asu-rdl/Primecam-Bias/README.md

# Primecam-Bias

See [https://asu-rdl.github.io/Primecam-Bias/](https://asu-rdl.github.io/Primecam-Bias/)
