asu-rdl/Primecam-Bias/docs/index.md

---
layout: default
---

# Intro
The CCAT observatory's instrument "Prime-Cam" requires a power supply for a large array of low-noise amplifiers. 
They want to have easy to use, programmable control over the power supply (also referred to as 'bias supply').
We (ASU) aim to deliver on that need. Within these docs, you can find 

# Table Of Contents

1. [Raspberry Pi Bringup](raspberrypi.html)
1. [Getting Started](gettingstarted.html)
1. [Software](software.html)
1. [Hardware](hardware.html)
