asu-rdl/Primecam-Bias/board/primecamLNABiasPotVreg-CostComp.ods

Option # | Description | Board Fab | Assemble | Parts Cost | ETA | Total
1 | JLC Fab + Assemble | 244.3 | 6939.98 | 0 | 2 weeks | 7184.28
2 | JLC Fab + ASU Assemble | 244.3 | 0 | 3114.22 | Much longer | 3358.52
 |  |  |  |  | Difference | 3825.76
