asu-rdl/Primecam-Bias/board/551XX09F.stp

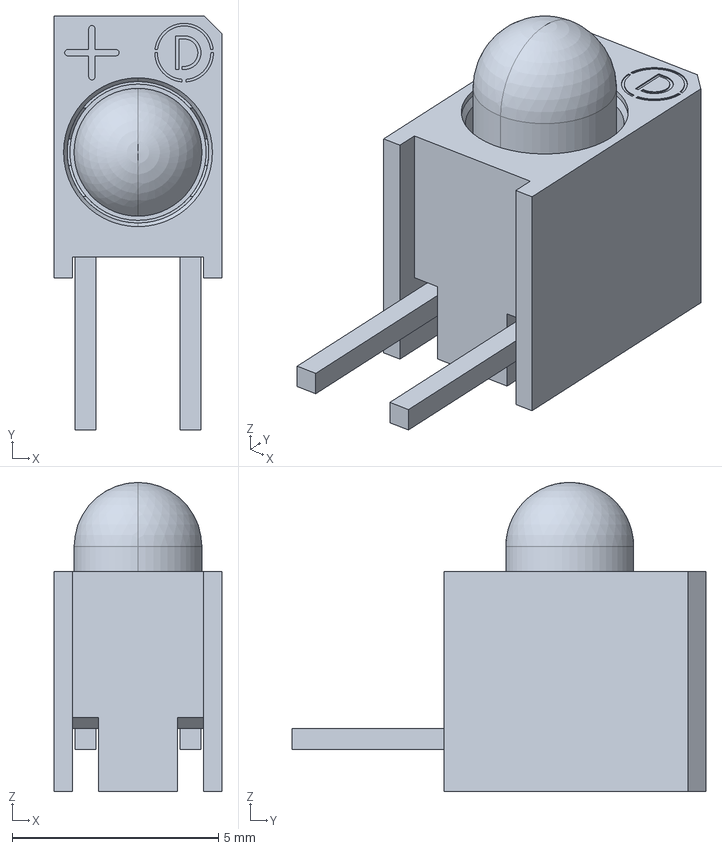
[picture p3: CAD file, 2025-06-06]
board/551XX09F.stp
4.06 x 10.0 x 7.49 mm
