asu-rdl/Primecam-Bias/buggyTodo.md

- [ ] Missing commands to enable a testload
- [ ] Wiper is not being correctly set during seek_voltage command.
- [ ] Implement seek_current
