asu-rdl/Primecam-Bias/docs/todo.md

---
layout: default
---

# Todo
---
- [ ]  How do we make sure poetry sets up the CLI as an executable.

# Notes
---
