asu-rdl/Primecam-Bias/docs/primecamLNABiasPotVreg.pdf

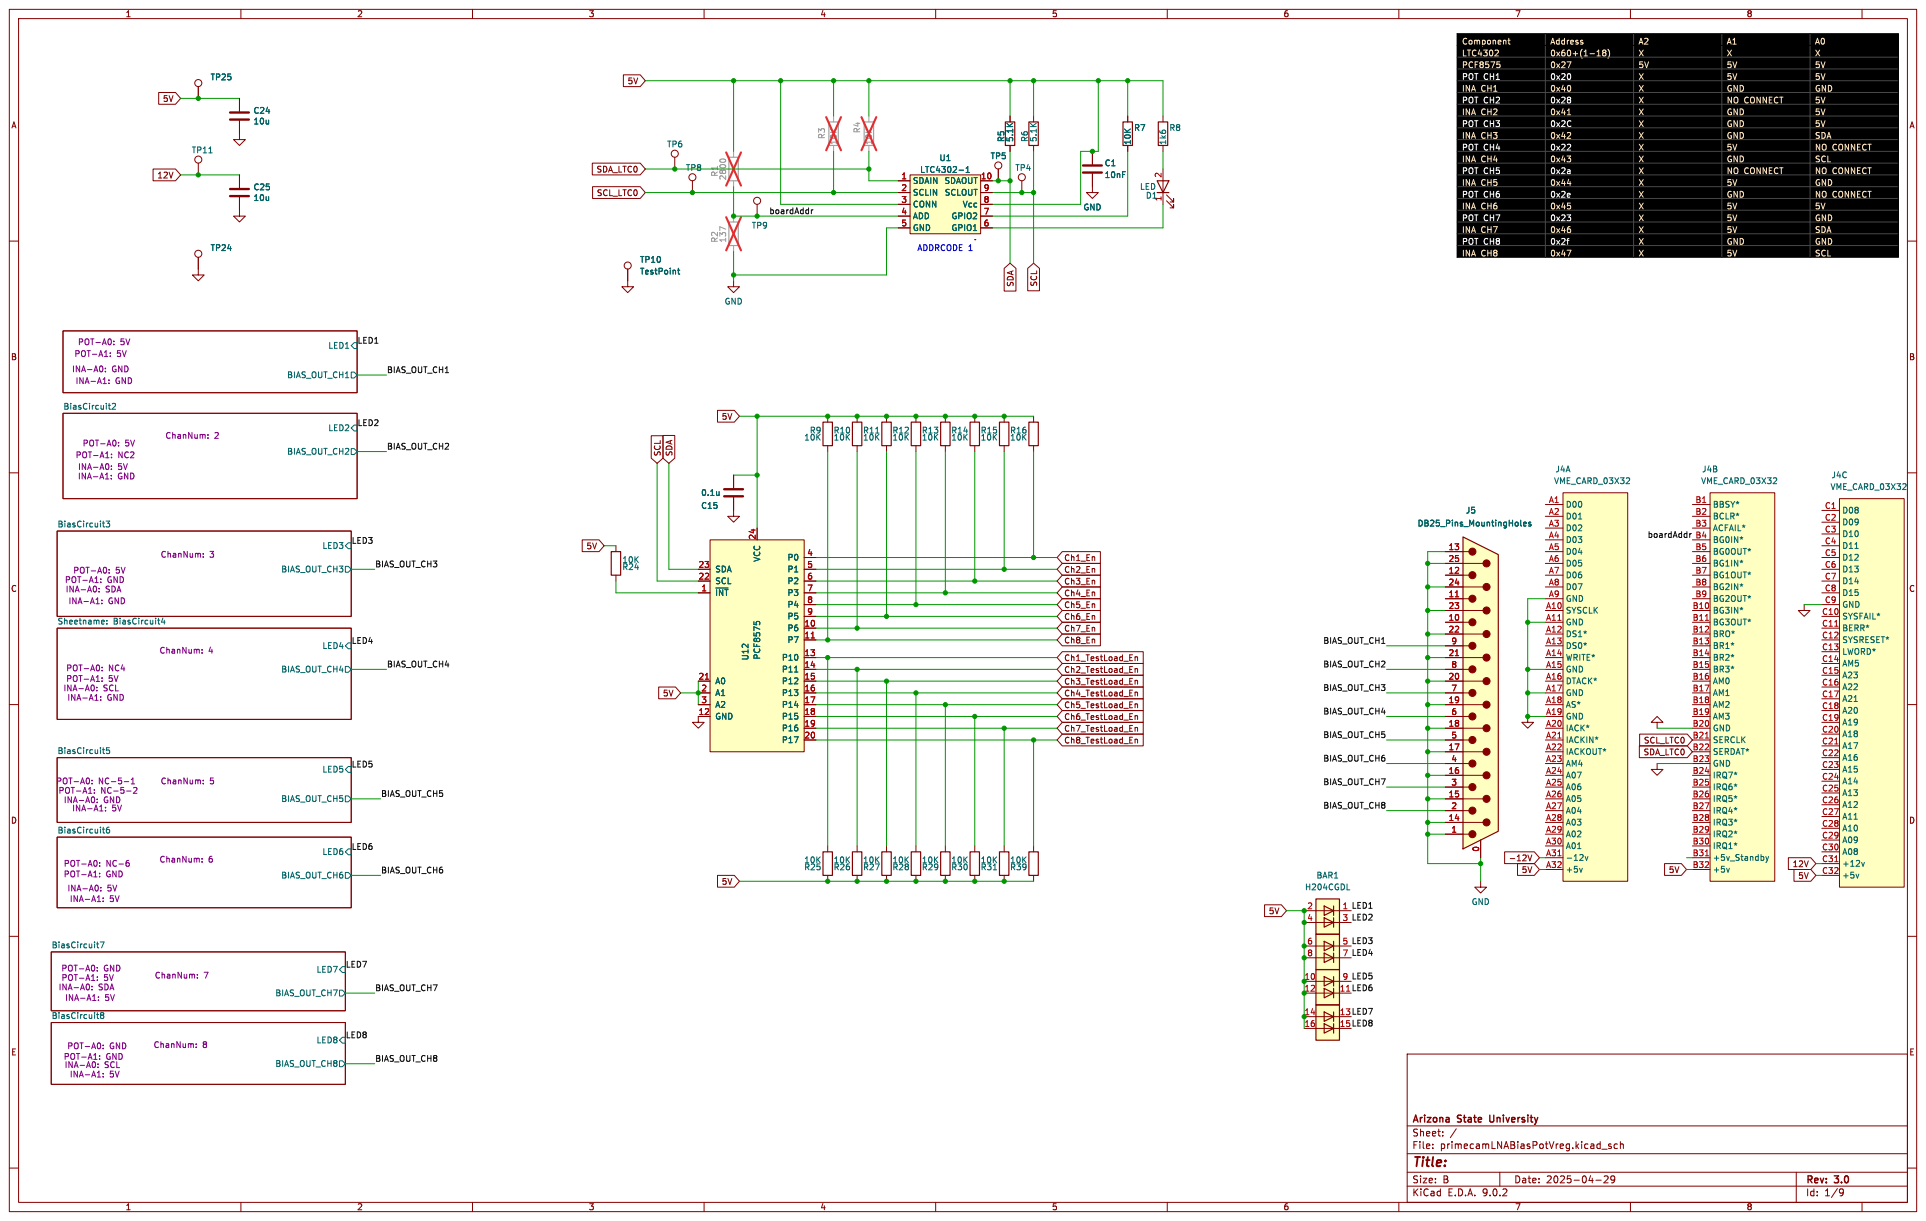
[picture p4: page 1]

Component | Address | A2 | A1 | A0
LTC4302 | 0x60+(1-18) | X | X | X
PCF8575 | 0x27 | 5V | 5V | 5V
POT CH1 | 0x20 | X | 5V | 5V
INA CH1 | 0x40 | X | GND | GND
POT CH2 | 0x28 | X | NO CONNECT | 5V
INA CH2 | 0x41 | X | GND | 5V
POT CH3 | 0x2C | X | GND | 5V
INA CH3 | 0x42 | X | GND | SDA
POT CH4 | 0x22 | X | 5V | NO CONNECT
INA CH4 | 0x43 0x2a | X X | GND NO CONNECT | SCL POT CH5 NO CONNECT

INA CH5 | 0x44 | X | 5V | GND
POT CH6 | 0x2e | X | GND | NO CONNECT
INA CH6 | 0x45 | X | 5V | 5V
POT CH7 | 0x23 | X | 5V | GND
INA CH7 | 0x46 | X | 5V | SDA
POT CH8 | 0x2f | X | GND | GND

VME_CARD_03X32 D00 A1 D01 A2 D02 A3 D03 A4 D04 A5 D05 A6 D06 A7 D07 A8 GND A9 SYSCLK A10 GND A11 DS1* A12 DS0* A13 WRITE* A14 GND A15 DTACK* A16 GND A17 AS* A18 GND A19
BBSY* B1 BCLR* B2 ACFAIL* B3 BG0IN* B4 BG0OUT* B5 BG1IN* B6 BG1OUT* B7 BG2IN* B8 BG2OUT* B9 BG3IN* B10 BG3OUT* B11 BRO* B12 BR1* B13 BR2* B14 BR3* B15 AM0 B16 AM1 B17 AM2 B18 AM3 B19 GND

POT-A0: NC-6 POT-A1: GND

Id: 1/9 Title: File: primecamLNABiasPotVreg.kicad_sch Sheet: / Arizona State University

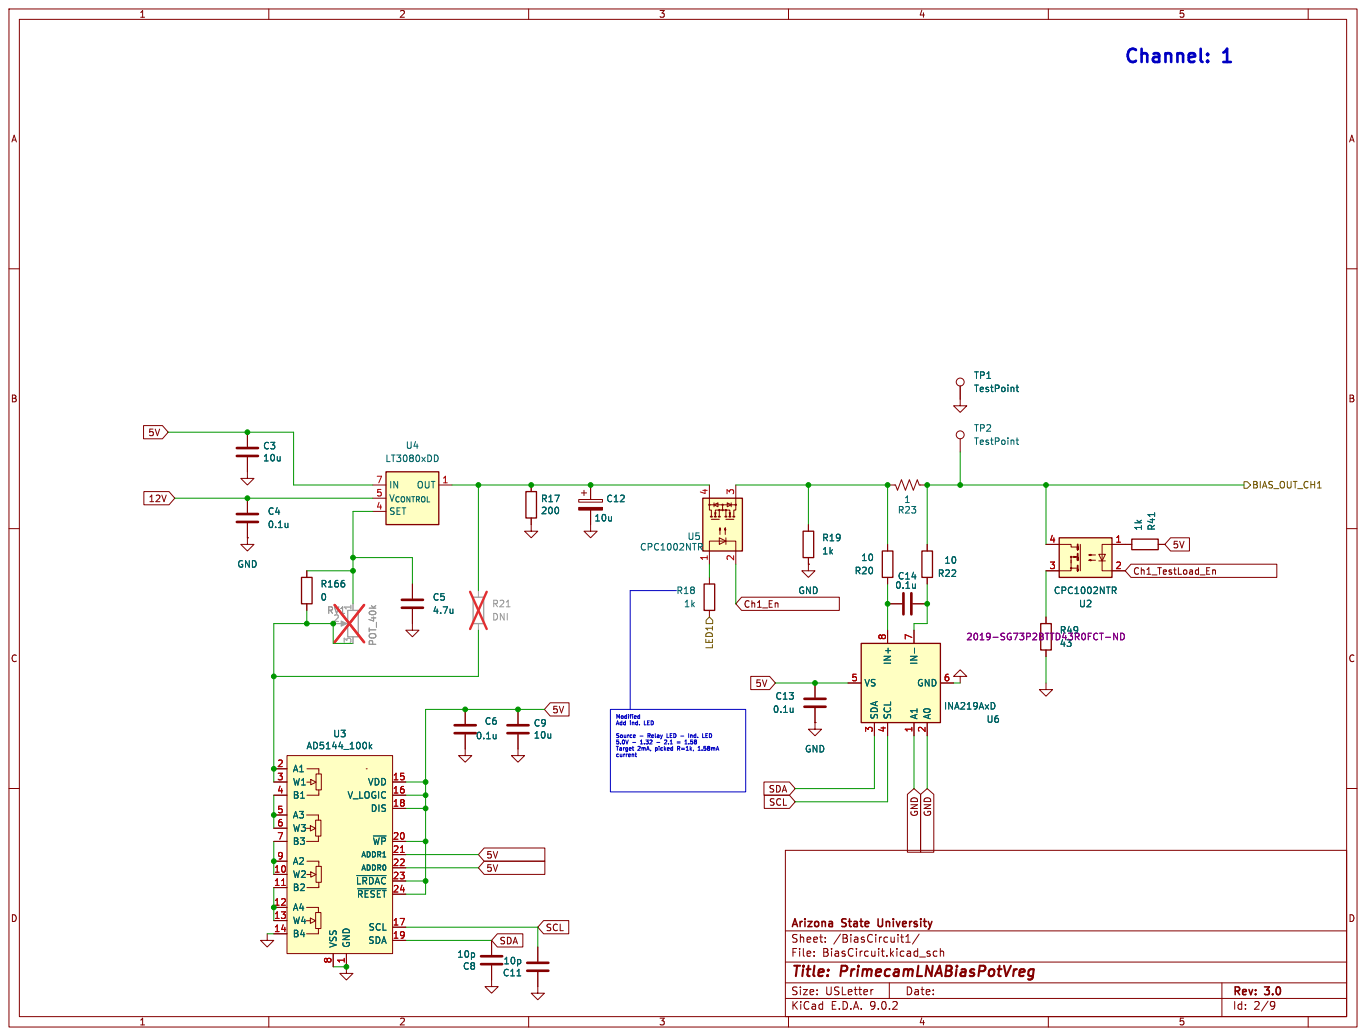
[picture p5: page 2]

File: BiasCircuit.kicad_sch Sheet: /BiasCircuit1/ Arizona State University C12

8 IN- 7 VS 5 GND 6 SDA
INA219AxD IN+

Modified Add ind. LED

Source - Relay LED - Ind. LED

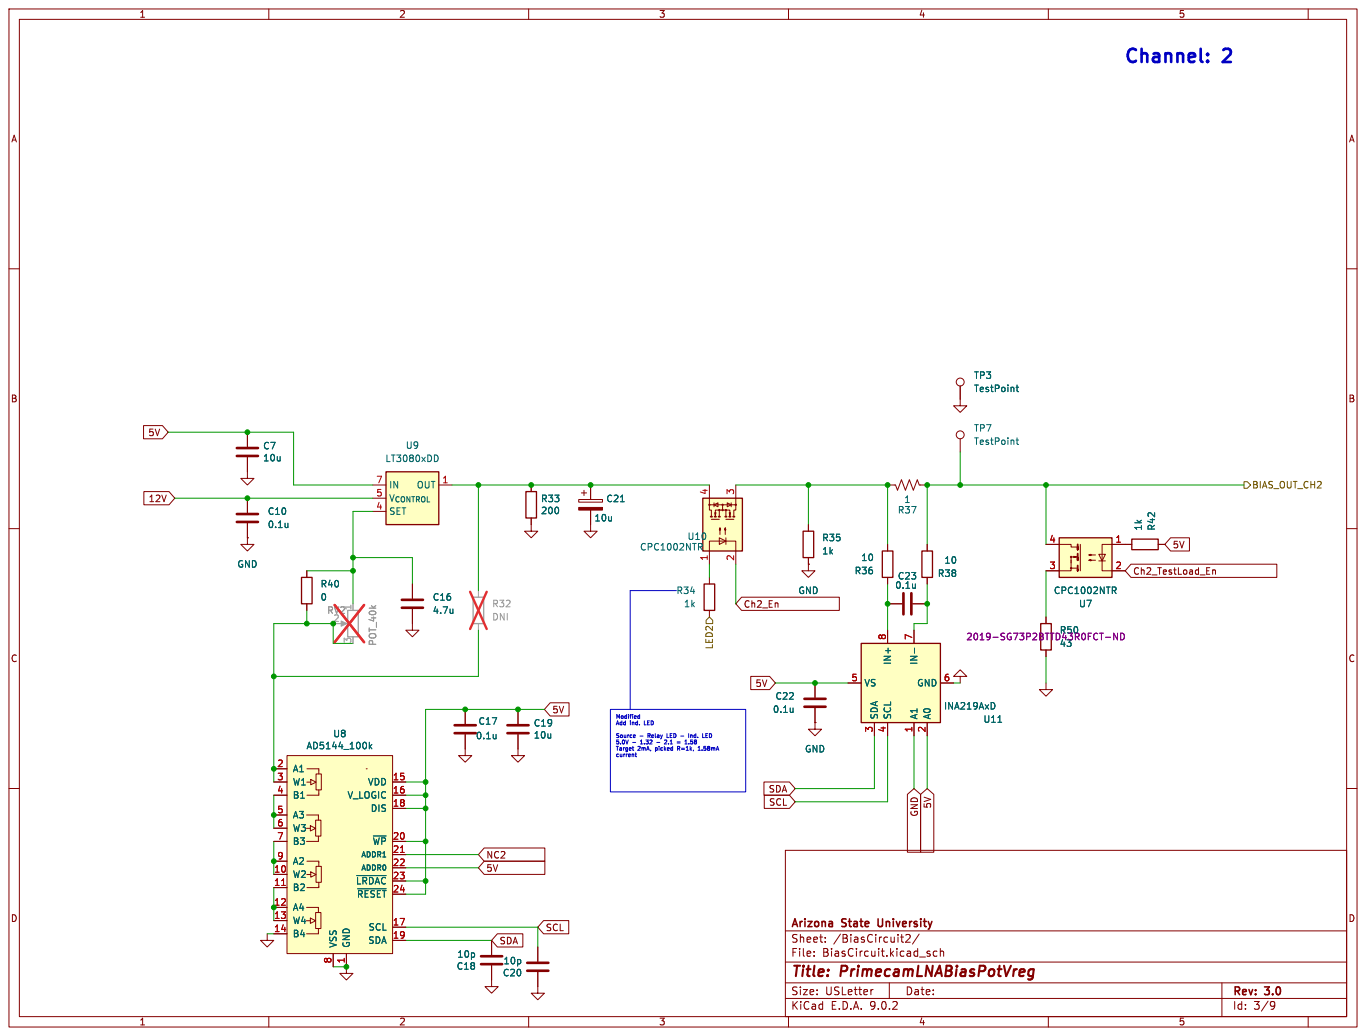
[picture p6: page 3]

File: BiasCircuit.kicad_sch Sheet: /BiasCircuit2/ Arizona State University R34

8 IN- 7 VS 5 GND 6 SDA
INA219AxD IN+

Modified Add ind. LED

Source - Relay LED - Ind. LED

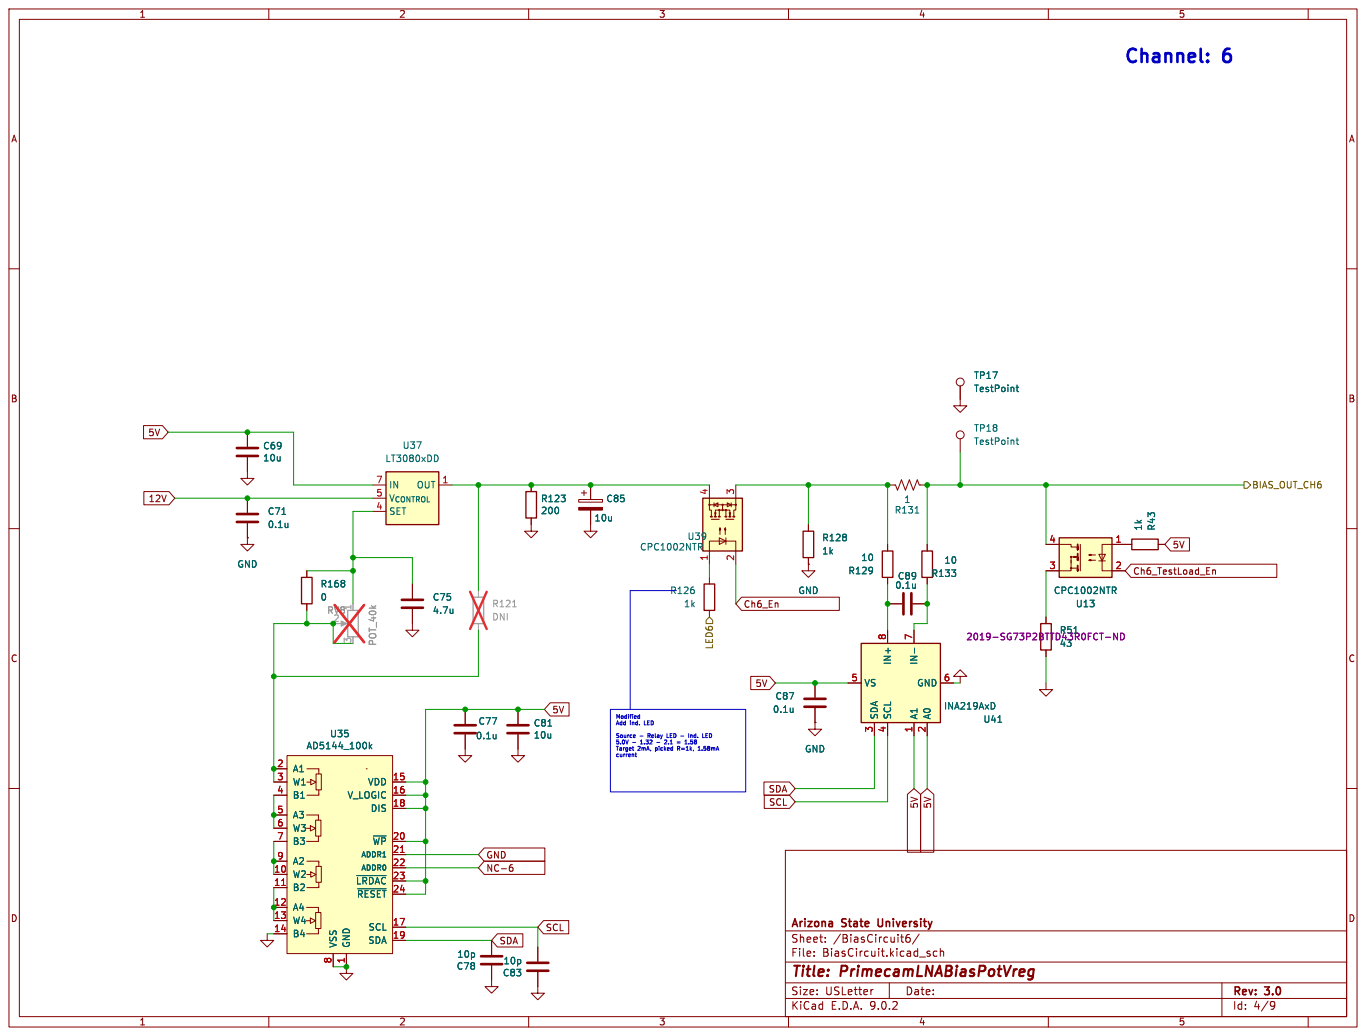
[picture p7: page 4]

8 IN- 7 VS 5 GND 6 SDA
INA219AxD IN+

Modified Add ind. LED

Source - Relay LED - Ind. LED

File: BiasCircuit.kicad_sch Sheet: /BiasCircuit6/ Arizona State University

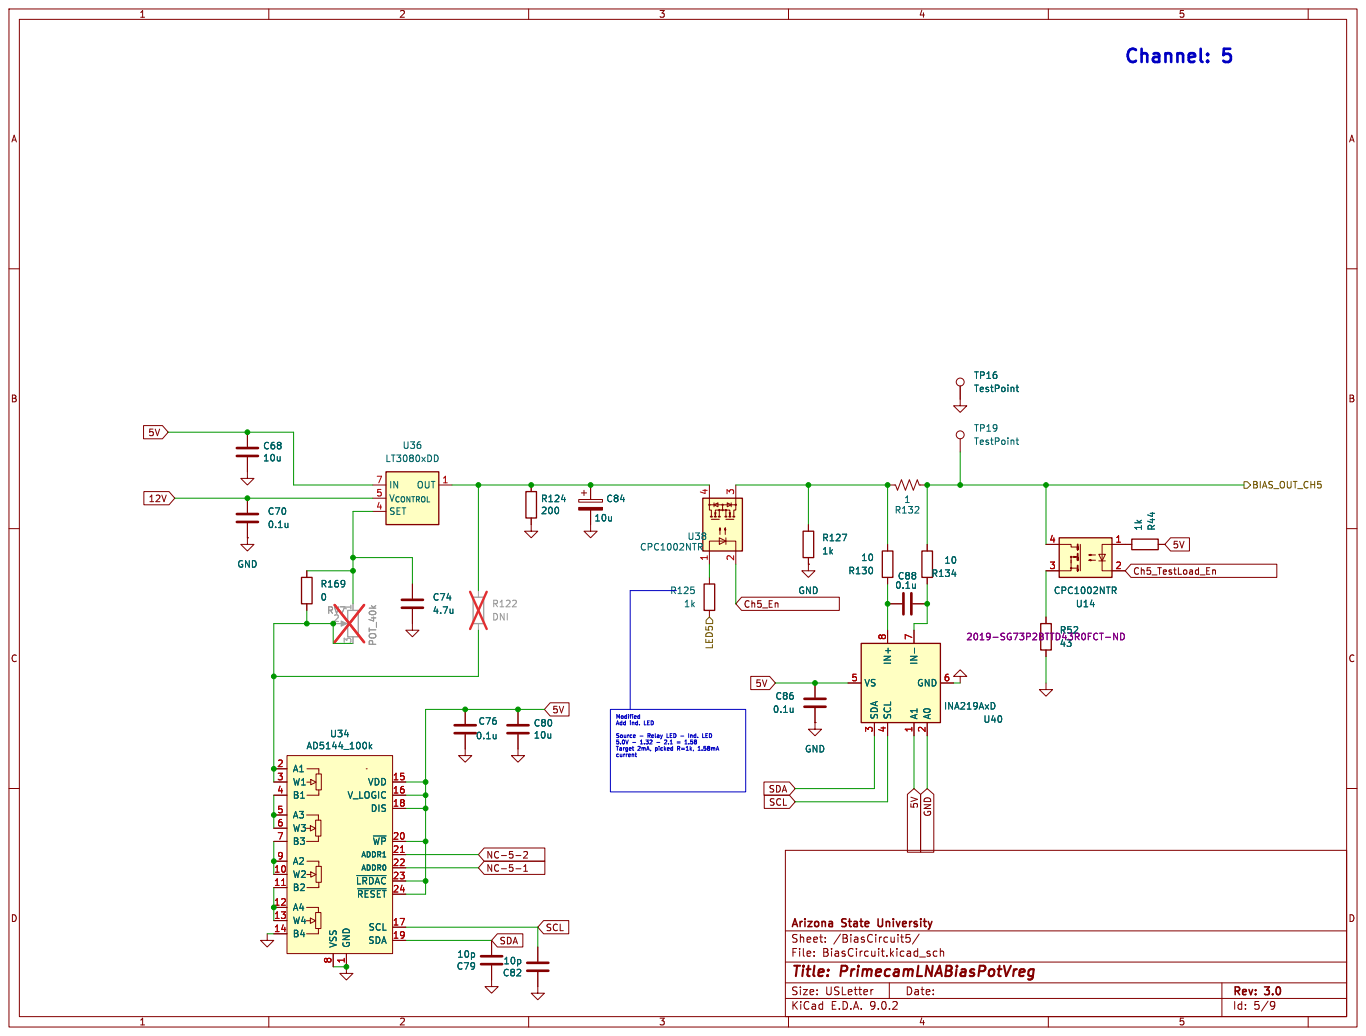
[picture p8: page 5]

File: BiasCircuit.kicad_sch Sheet: /BiasCircuit5/ Arizona State University C84

8 IN- 7 VS 5 GND 6 SDA
INA219AxD IN+

Modified Add ind. LED

Source - Relay LED - Ind. LED

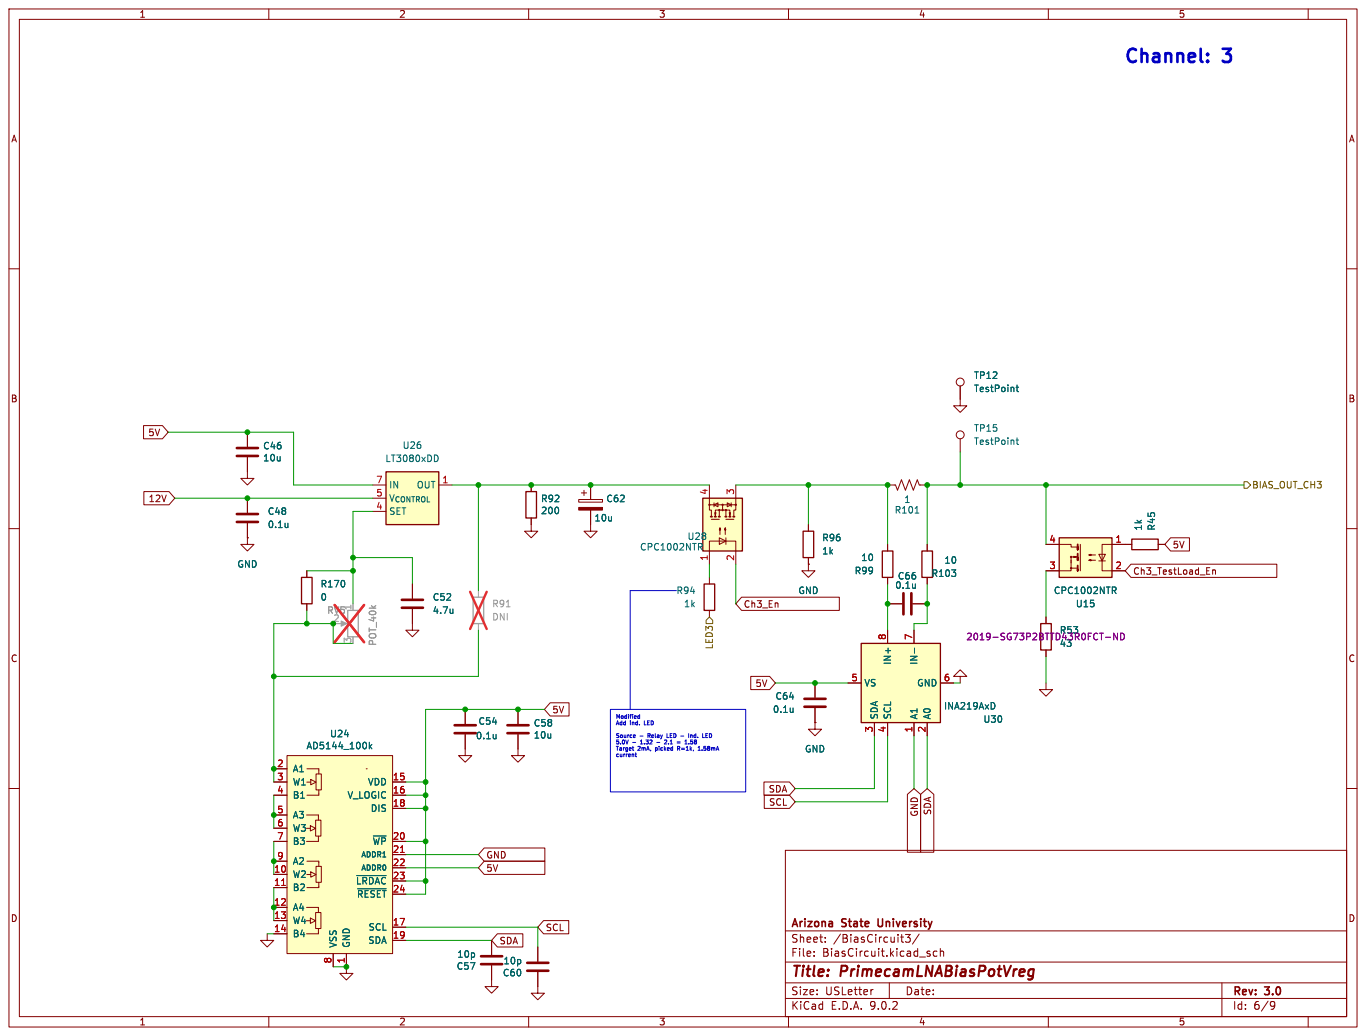
[picture p9: page 6]

File: BiasCircuit.kicad_sch Sheet: /BiasCircuit3/ Arizona State University R94

8 IN- 7 VS 5 GND 6 SDA
INA219AxD IN+

Modified Add ind. LED

Source - Relay LED - Ind. LED

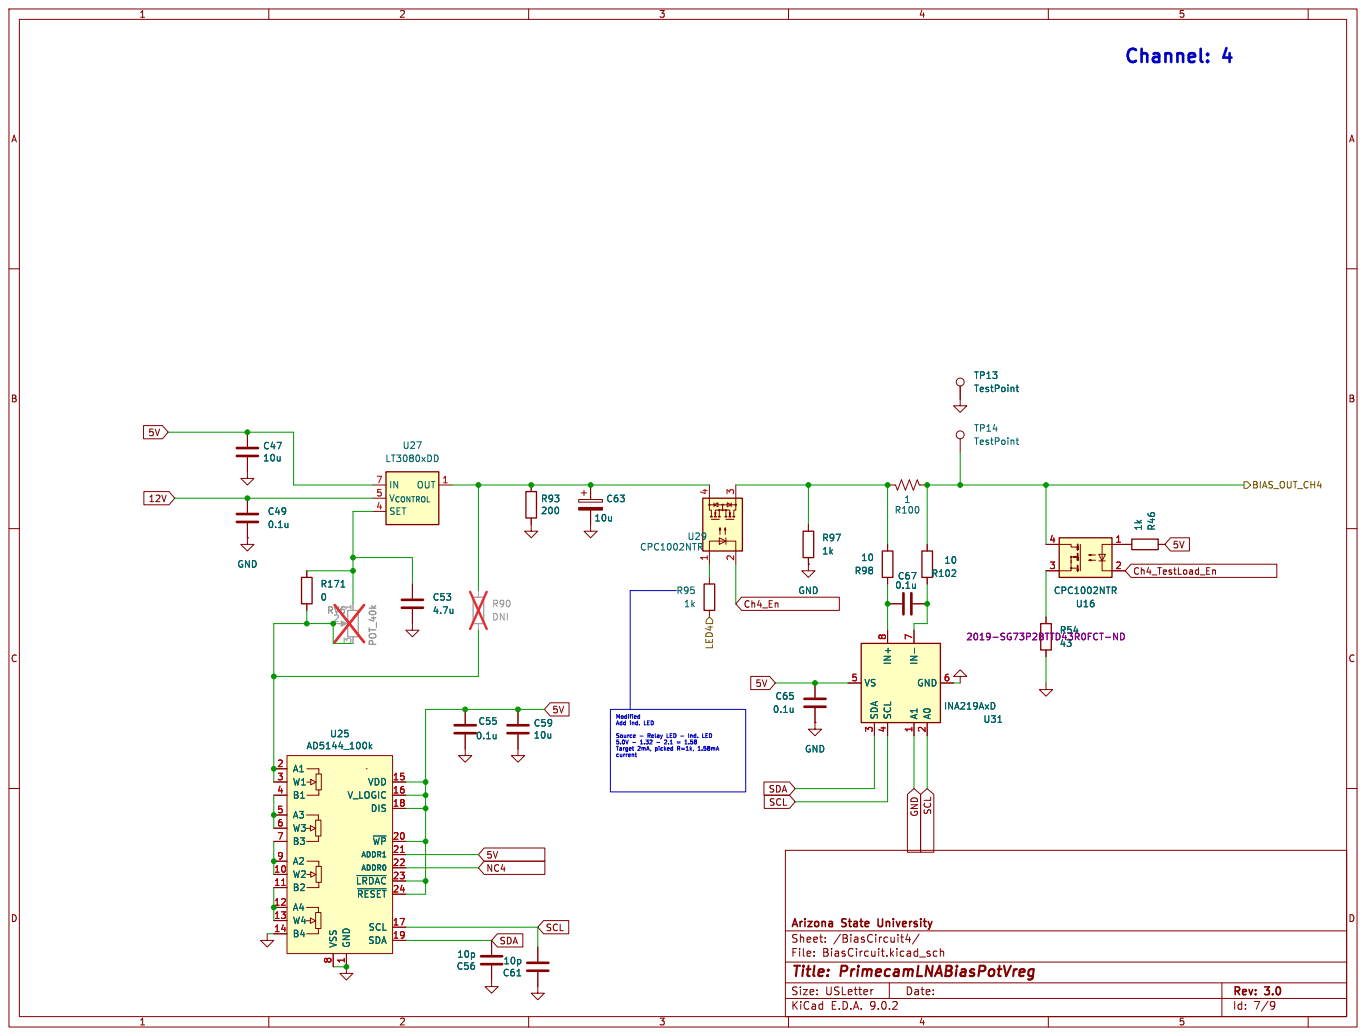
[picture p10: page 7]

8 IN- 7 VS 5 GND 6 SDA
INA219AxD IN+

Modified Add ind. LED

Source - Relay LED - Ind. LED

File: BiasCircuit.kicad_sch Sheet: /BiasCircuit4/ Arizona State University

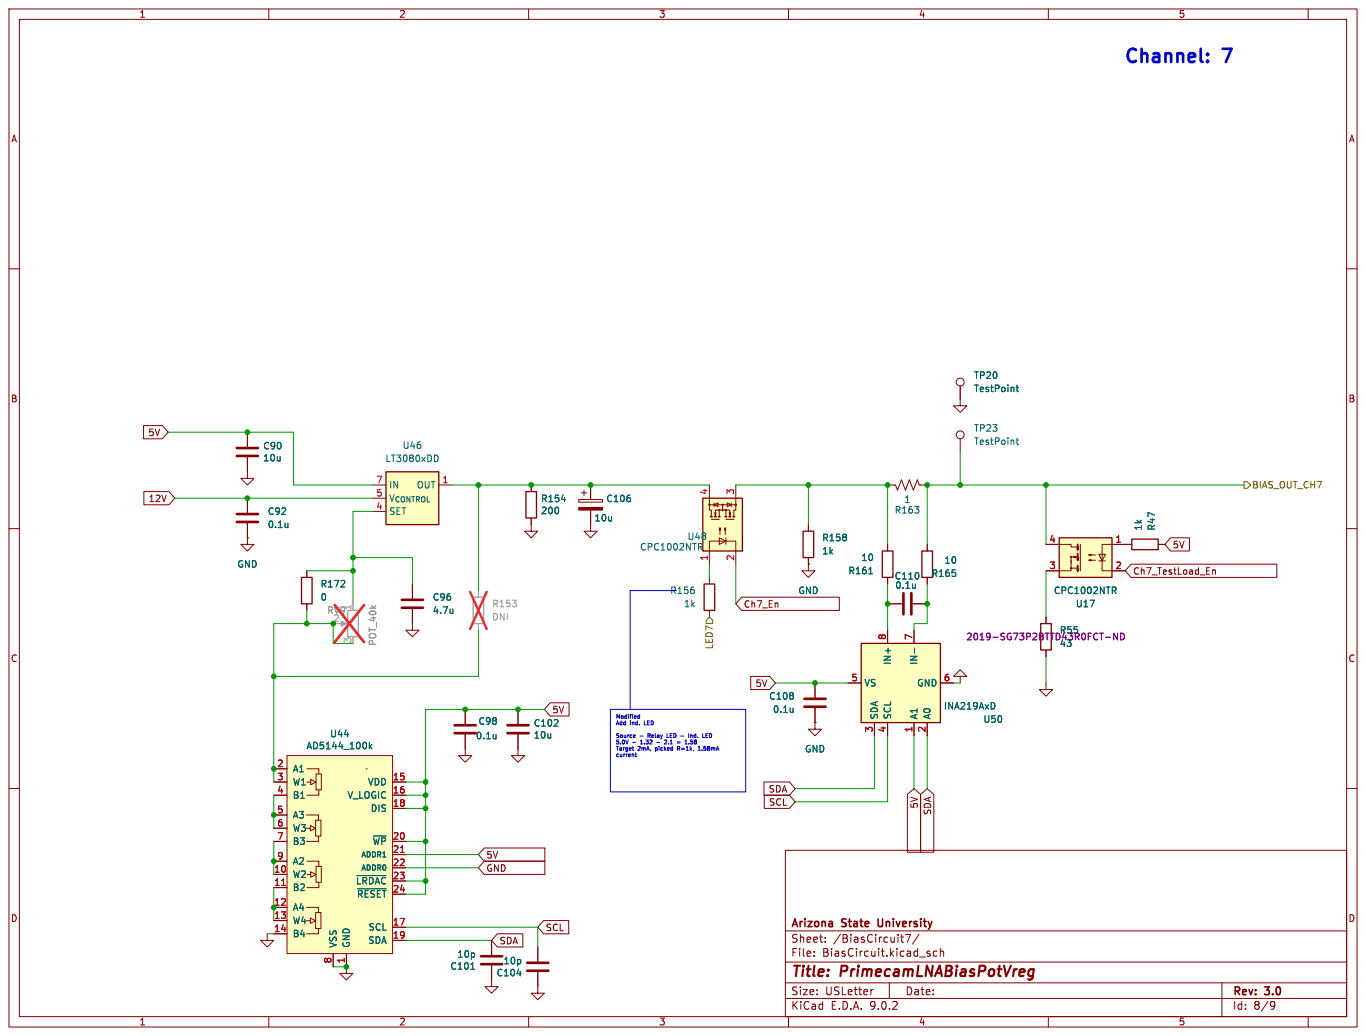
[picture p11: page 8]

File: BiasCircuit.kicad_sch Sheet: /BiasCircuit7/ Arizona State University C106

8 IN- 7 VS 5 GND 6 SDA
INA219AxD IN+

Modified Add ind. LED

Source - Relay LED - Ind. LED

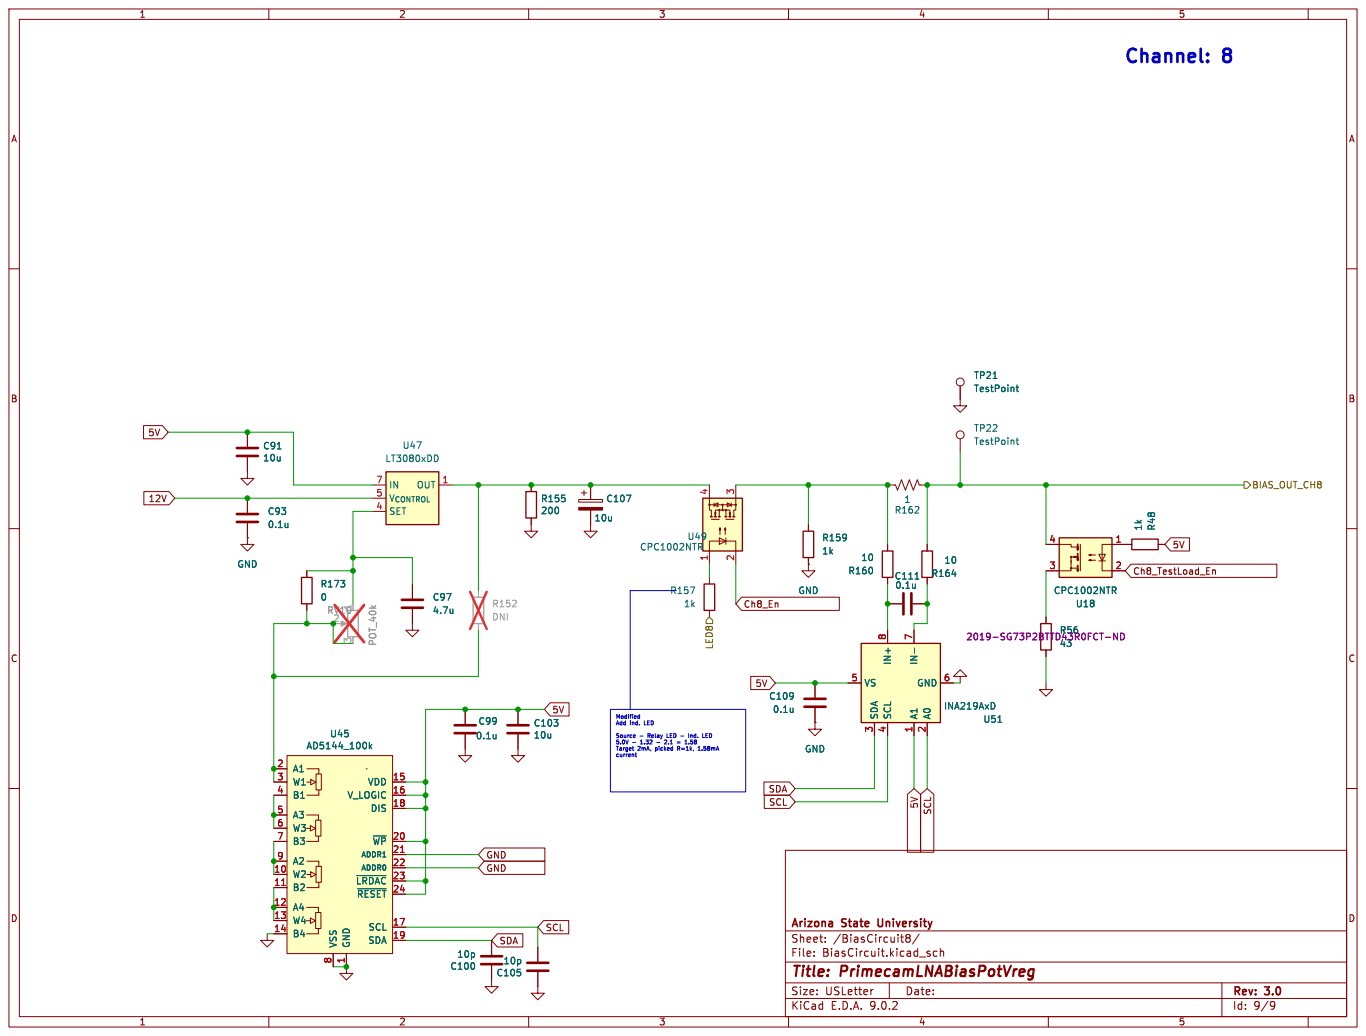
[picture p12: page 9]

File: BiasCircuit.kicad_sch Sheet: /BiasCircuit8/ Arizona State University R157

8 IN- 7 VS 5 GND 6 SDA
INA219AxD IN+

Modified Add ind. LED

Source - Relay LED - Ind. LED
