asu-rdl/Primecam-Bias/docs/primecamLNABiasPotVreg-B_Cu.pdf

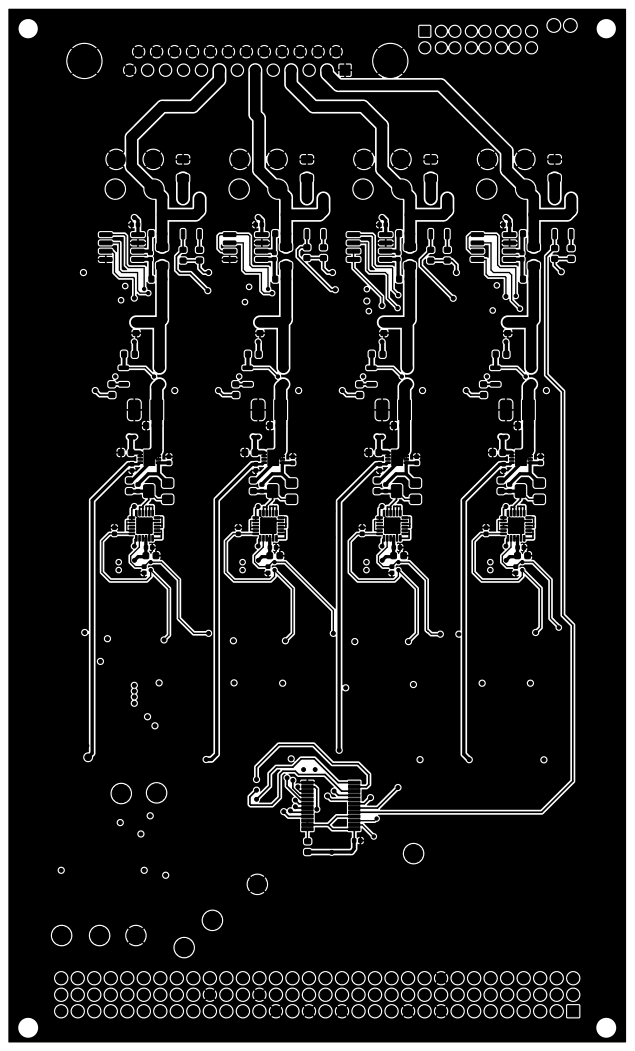
[picture p13: page 1]
