asu-rdl/Primecam-Bias/docs/primecamLNABiasPotVreg-F_Cu.pdf

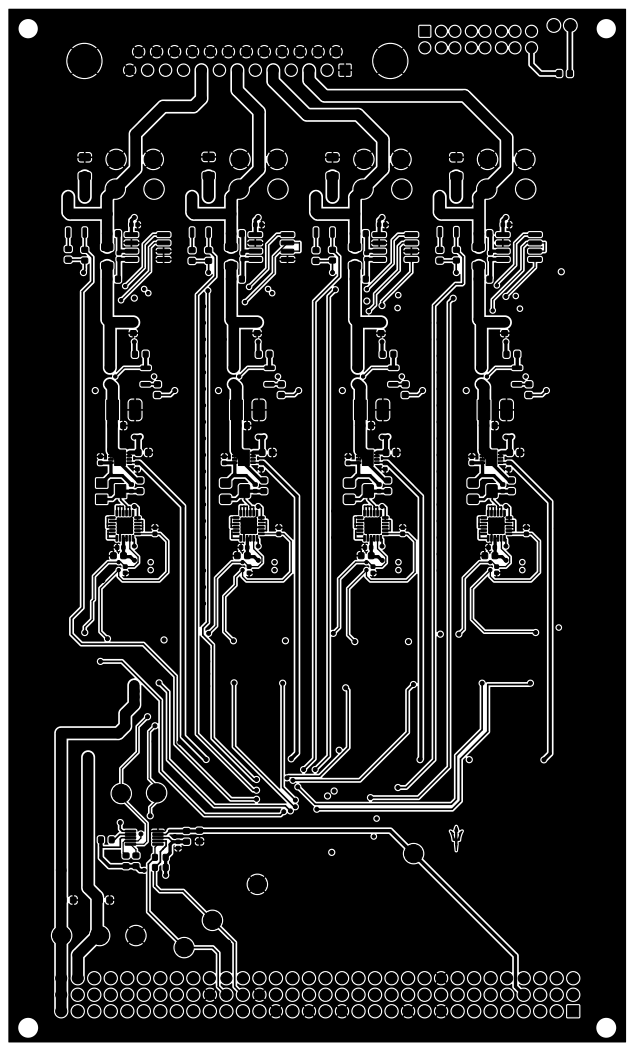
[picture p14: page 1]
