asu-rdl/Primecam-Bias/docs/primecamLNABiasPotVreg-In1_Cu.pdf

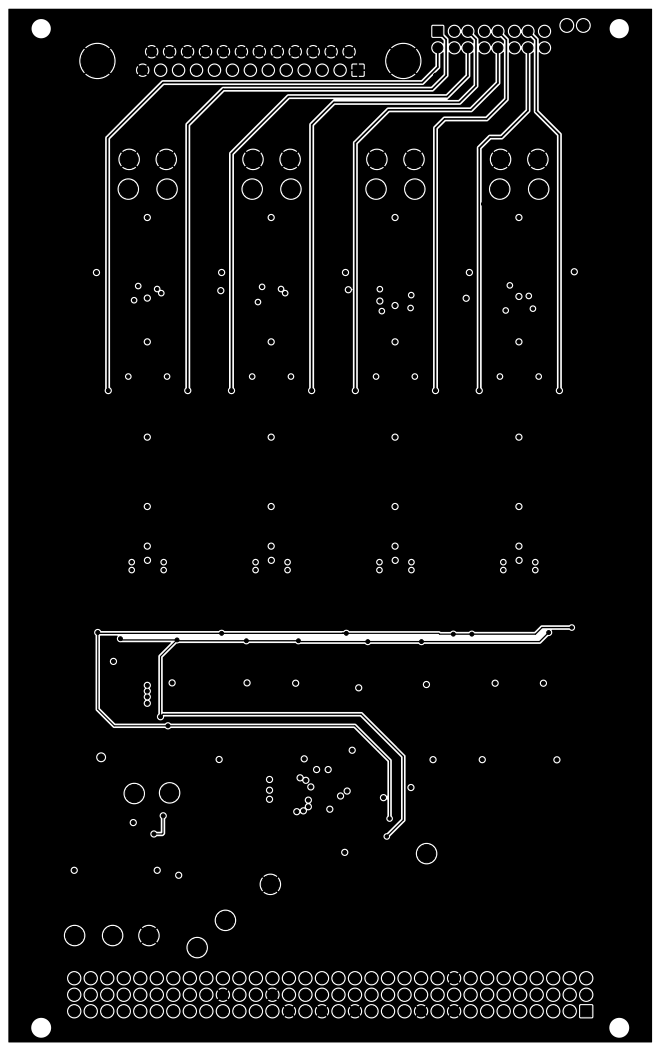
[picture p15: page 1]
