asu-rdl/Primecam-Bias/docs/primecamLNABiasPotVreg-In2_Cu.pdf

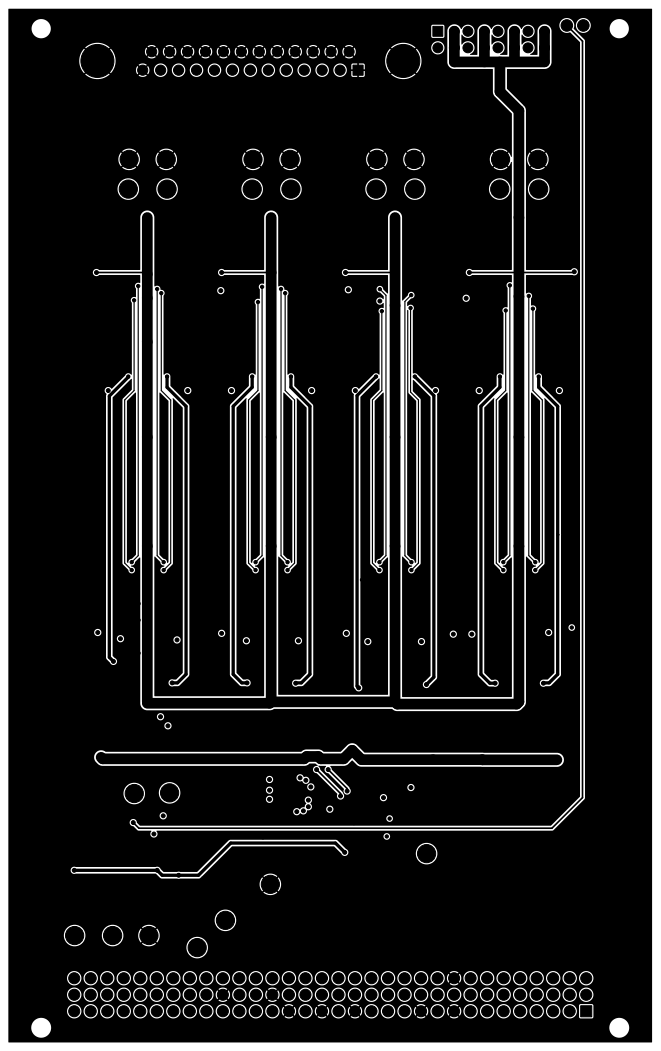
[picture p16: page 1]
