asu-rdl/Primecam-Bias/board/primecamLNABiasPotVreg_2ch.kicad_pcb

## KiCad design board/primecamLNABiasPotVreg_2ch.kicad_pcb (2025-06-06)

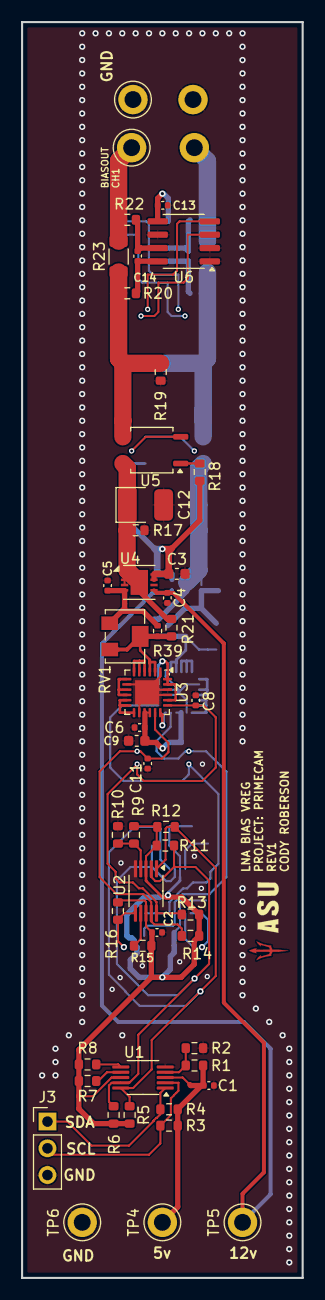
[picture p17: board primecamLNABiasPotVreg_2ch.kicad_pcb from above]

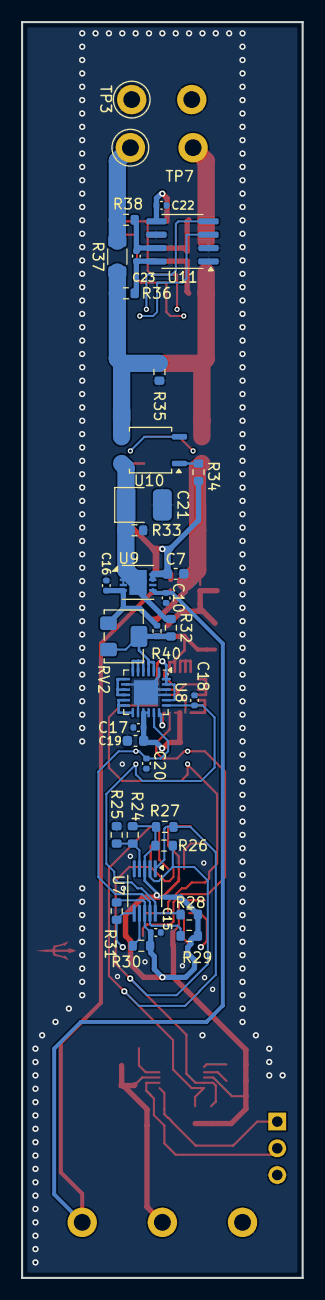
[picture p18: board primecamLNABiasPotVreg_2ch.kicad_pcb from below]

Board: 4 copper layers, 26.7 x 119.4 mm, 84 parts (35 on the bottom side), 42 nets.

Parts:
C1, C2, C15: 10nF; C_0402_1005Metric
C3, C7, C9, C19: 10u; C_0603_1608Metric
C4, C6, C10, C13, C14, C17, C22, C23: 0.1u; C_0402_1005Metric
C5, C16: 4.7u; C_0402_1005Metric
C8, C11, C18, C20: 10p; C_0402_1005Metric
C12, C21: 10u; Cap_b_1411
J3: Conn_01x03; PinHeader_1x03_P2.54mm_Vertical
R1: 2800; R_0603_1608Metric
R2: 137; R_0603_1608Metric
R3, R4, R7, R8, R11, R12, R15, R16, R26, R27, R30, R31: 10K; R_0603_1608Metric
R5, R6, R13, R14, R28, R29: 5.1K; R_0603_1608Metric
R9, R24: 1150; R_0603_1608Metric
R10, R25: 2050; R_0603_1608Metric
R17, R33: 200; R_0603_1608Metric
R18, R34: 3k65; R_0603_1608Metric
R19, R35: 1k; R_0603_1608Metric
R20, R21, R22, R32, R36, R38: 10; R_0603_1608Metric
R23, R37: 1; R_1206_3216Metric
R39, R40: 0; R_0402_1005Metric
RV1, RV2: POT_40k; Potentiometer_Bourns_3224W_Vertical
TP1, TP2, TP3, TP4, TP5, TP6, TP7: TestPoint; TestPoint_Keystone_5005-5009_Compact
U1, U2, U7: LTC4302-1; MSOP-10_3x3mm_P0.5mm
U3, U8: AD5144_100k; LFCSP-24-1EP_4x4mm_P0.5mm_EP2.3x2.3mm
U4, U9: LT3080xDD; DFN-8-1EP_3x3mm_P0.5mm_EP1.66x2.38mm
U5, U10: AQY212G3HS; SOP-4_3.8x4.1mm_P2.54mm
U6, U11: INA219AxD; SOIC-8_3.9x4.9mm_P1.27mm

Connections:
5V: C1.2, C2.2, C3.1, C6.2, C7.1, C9.1, C13.1, C15.2, C17.2, C19.1, C22.1, R1.1, R3.1, R4.1, R5.1, R6.1, R7.1, R8.1, R9.1, R11.1, R12.1, R13.1, R14.1, R15.1, R16.1, R18.2, R24.1, R26.1, R27.1, R28.1, R29.1, R30.1, R31.1, R34.2, TP4.1, U1.3 (CONN), U1.8 (Vcc), U2.3 (CONN), U2.8 (Vcc), U3.15 (VDD), U3.16 (V_LOGIC), U3.18 (DIS), U3.20 (~WP), U3.23 (~LRDAC), U3.24 (~RESET), U4.7 (IN), U4.8 (IN), U6.5 (VS), U7.3 (CONN), U7.8 (Vcc), U8.15 (VDD), U8.16 (V_LOGIC), U8.18 (DIS), U8.20 (~WP), U8.23 (~LRDAC), U8.24 (~RESET), U9.7 (IN), U9.8 (IN), U11.5 (VS)
12V: C4.1, C10.1, TP5.1, U4.5 (V_{CONTROL}), U9.5 (V_{CONTROL})
/BIAS_OUT_CH1: R22.2, R23.2, TP2.1
/BIAS_OUT_CH2: R37.2, R38.2, TP7.1
/BiasCircuit1/GPIO1: R31.2, U7.6 (GPIO1), U10.2
/BiasCircuit1/SCL2: C20.2, R29.2, U7.9 (SCLOUT), U8.17 (SCL), U11.4 (SCL)
/BiasCircuit1/SDA2: C18.2, R28.2, U7.10 (SDAOUT), U8.19 (SDA), U11.3 (SDA)
/BiasCircuit/GPIO1: R16.2, U2.6 (GPIO1), U5.2
/BiasCircuit/SCL1: C11.2, R14.2, U2.9 (SCLOUT), U3.17 (SCL), U6.4 (SCL)
/BiasCircuit/SDA1: C8.2, R13.2, U2.10 (SDAOUT), U3.19 (SDA), U6.3 (SDA)
/SCL_BiasCircuit: R6.2, R11.2, R26.2, U1.9 (SCLOUT), U2.2 (SCLIN), U7.2 (SCLIN)
/SDA_BiasCircuit: R5.2, R12.2, R27.2, U1.10 (SDAOUT), U2.1 (SDAIN), U7.1 (SDAIN)
GND: C1.1, C2.1, C3.2, C4.2, C5.2, C6.1, C7.2, C8.1, C9.2, C10.2, C11.1, C12.2, C13.2, C15.1, C16.2, C17.1, C18.1, C19.2, C20.1, C21.2, C22.2, J3.3, R2.2, R10.2, R17.2, R19.2, R25.2, R33.2, R35.2, TP1.1, TP3.1, TP6.1, U1.5 (GND), U2.5 (GND), U3.1 (GND), U3.8 (VSS), U3.14 (B4), U3.21 (ADDR1), U3.22 (ADDR0), U3.25 (PAD), U6.1 (A1), U6.2 (A0), U6.6 (GND), U7.5 (GND), U8.1 (GND), U8.8 (VSS), U8.14 (B4), U8.21 (ADDR1), U8.22 (ADDR0), U8.25 (PAD), U11.1 (A1), U11.2 (A0), U11.6 (GND)
unnamed: C12.1, R17.1, R21.1, U4.1 (OUT), U4.2 (OUT), U4.3 (OUT), U4.9 (OUT), U5.4
unnamed: C21.1, R32.1, R33.1, U9.1 (OUT), U9.2 (OUT), U9.3 (OUT), U9.9 (OUT), U10.4
unnamed: R18.1, U5.1
unnamed: R19.1, R20.2, R23.1, U5.3
unnamed: R34.1, U10.1
unnamed: R35.1, R36.2, R37.1, U10.3
unnamed: R1.2, R2.1, U1.4 (ADD)
unnamed: R8.2, U1.6 (GPIO1)
unnamed: R7.2, U1.7 (GPIO2)
unnamed: R9.2, R10.1, U2.4 (ADD)
unnamed: R15.2, U2.7 (GPIO2)
unnamed: R21.2, R39.2, RV1.2, RV1.3, U3.2 (A1), U3.3 (W1)
unnamed: U3.7 (B3), U3.9 (A2), U3.10 (W2)
unnamed: U3.4 (B1), U3.5 (A3), U3.6 (W3)
unnamed: U3.11 (B2), U3.12 (A4), U3.13 (W4)
unnamed: C5.1, R39.1, RV1.1, U4.4 (SET)
unnamed: C14.2, R20.1, U6.8 (IN+)
unnamed: C14.1, R22.1, U6.7 (IN-)
unnamed: R24.2, R25.1, U7.4 (ADD)
unnamed: R30.2, U7.7 (GPIO2)
unnamed: R32.2, R40.2, RV2.2, RV2.3, U8.2 (A1), U8.3 (W1)
unnamed: U8.7 (B3), U8.9 (A2), U8.10 (W2)
unnamed: U8.4 (B1), U8.5 (A3), U8.6 (W3)
unnamed: U8.11 (B2), U8.12 (A4), U8.13 (W4)
unnamed: C16.1, R40.1, RV2.1, U9.4 (SET)
unnamed: C23.2, R36.1, U11.8 (IN+)
unnamed: C23.1, R38.1, U11.7 (IN-)
SCL_LTC0: J3.2, R3.2, U1.2 (SCLIN)
SDA_LTC0: J3.1, R4.2, U1.1 (SDAIN)
