asu-rdl/Primecam-Bias/(commit log)

2025-04-04 Uploaded board
    Revision 1, Layout modified to reflect Top circuit layout onto back copper. Potentially ready for implementation of full VME card design.
    [BiasCircuit.kicad_sch, VMECARDTEMPLATE.kicad_pcb, primecamLNABiasPotVreg.kicad_pcb, primecamLNABiasPotVreg.kicad_sch]
2025-04-04 Added Arduino code for prototype testbench
    Meant to be used with an Arduino Nano Every
2025-04-09 added build via docker
    Created a cargo package. Configured for both x86_64 and aarch64 for the
    raspberry pi. Added ingredients for cross compiling via docker image.
2025-04-19 init python project, add cli
    Added a CLI skeleton for board testing. Updated documentation
2025-04-21 impl some LowLevel board functions
2025-05-07 added ina219 implementation
    fix addresses, ina219 datatypes
    Fixed INA219 datatypes. Current sense chip returns two's compliment
    signed values which erroneously treated as uint16 when it should be
    int16. This resulted in negative shunt voltages such as -0.1 mV being
    reported as 635.35mV which is not possbile.
    Wiper addresses were not currect. They are now.
    fixed chan en.
    It makes more sense to have the daemon care about the config instead of
    the hardware module
    relocated functions
    progress check
    A more formal structure (sub to change has been layed out)
    Modified Config file, added midlevel impl
    checkpoint
    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
    [daemon.py, dconf.py, hardware.py, midlevel.py]
2025-06-06 Fixed commanding and pass unit testing for getstatus
    [daemon.py]
2025-06-06 updateboard, added seekcurrenttest
    [551XX09F.stp, BiasCircuit.kicad_sch, primecamLNABiasPotVreg-CostComp.ods, primecamLNABiasPotVreg.kicad_sch, primecamLNABiasPotVreg_2ch.kicad_pcb, primecamLNABiasPotVreg_2ch.kicad_sch]
2025-06-12 silent failure on no redis server present. Oops
    [daemon.py]
